N-Pulse/Haptics-2026/Mechanics/CAD's/Flexion feedback/V1_Rotation_big_cylinder/Flexion_V1_main.stl

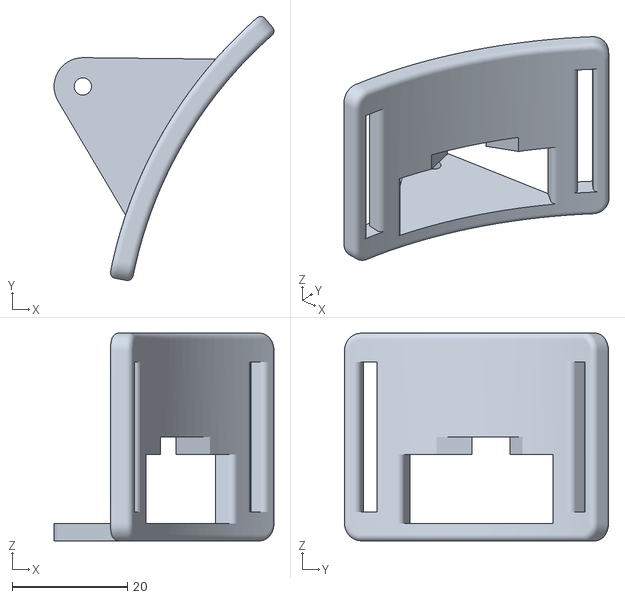
[picture p16: CAD file, 2026-10-17]
Mechanics/CAD's/Flexion feedback/V1_Rotation_big_cylinder/Flexion_V1_main.stl
38.1 x 45.8 x 36.0
