N-Pulse/Haptics-2026/Mechanics/CAD's/Flexion feedback/V2_Rotation_2_small_cylinders/Flexion_V2_main.stl

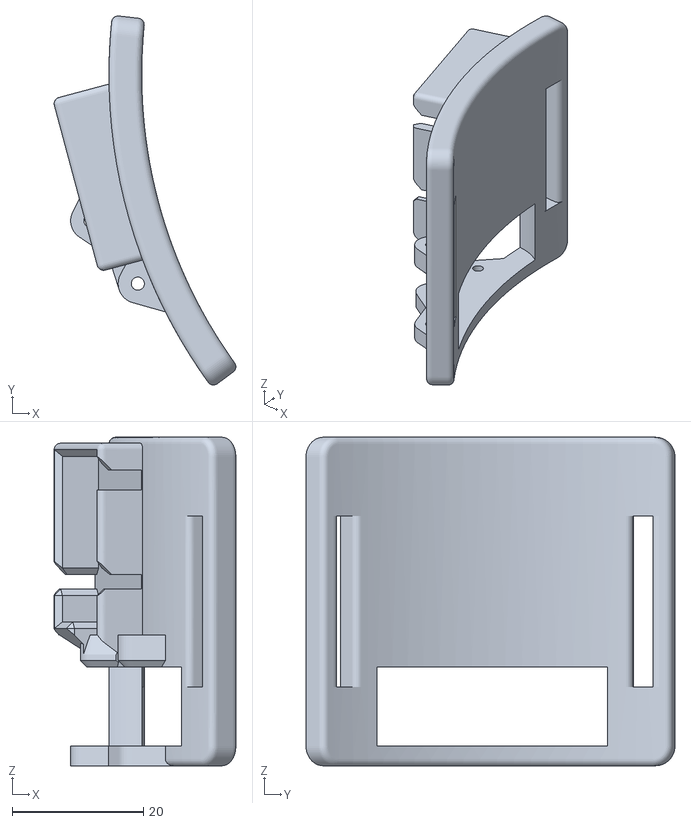
[picture p17: CAD file, 2026-10-17]
Mechanics/CAD's/Flexion feedback/V2_Rotation_2_small_cylinders/Flexion_V2_main.stl
27.7 x 56.2 x 50.0
