N-Pulse/Haptics-2026/Mechanics/CAD's/Flexion feedback/V3_linear/Flexion_V3.3_main.stl

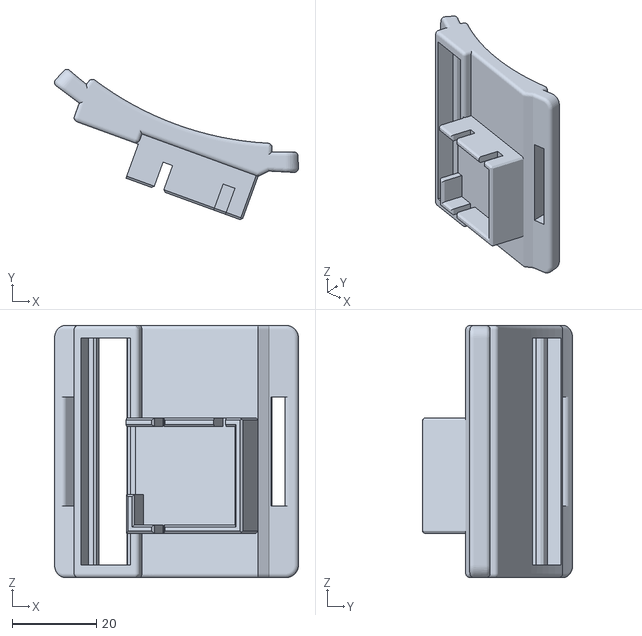
[picture p18: CAD file, 2026-10-30]
Mechanics/CAD's/Flexion feedback/V3_linear/Flexion_V3.3_main.stl
58.0 x 35.8 x 60.0
