N-Pulse/Haptics-2026/Mechanics/CAD's/Battery pack/Battery_board_V1_main.stl

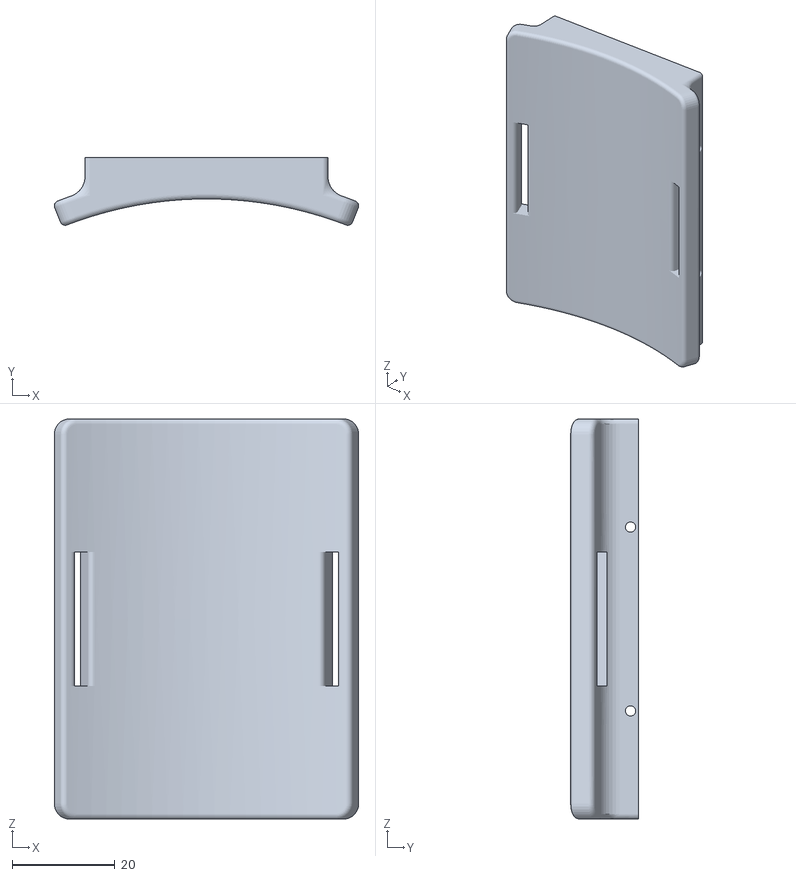
[picture p19: CAD file, 2026-10-23]
Mechanics/CAD's/Battery pack/Battery_board_V1_main.stl
59.1 x 13.1 x 77.7
