N-Pulse/Haptics-2026/Mechanics/CAD's/Pressure feedback/V3/Pressure_V3.1_main.stl

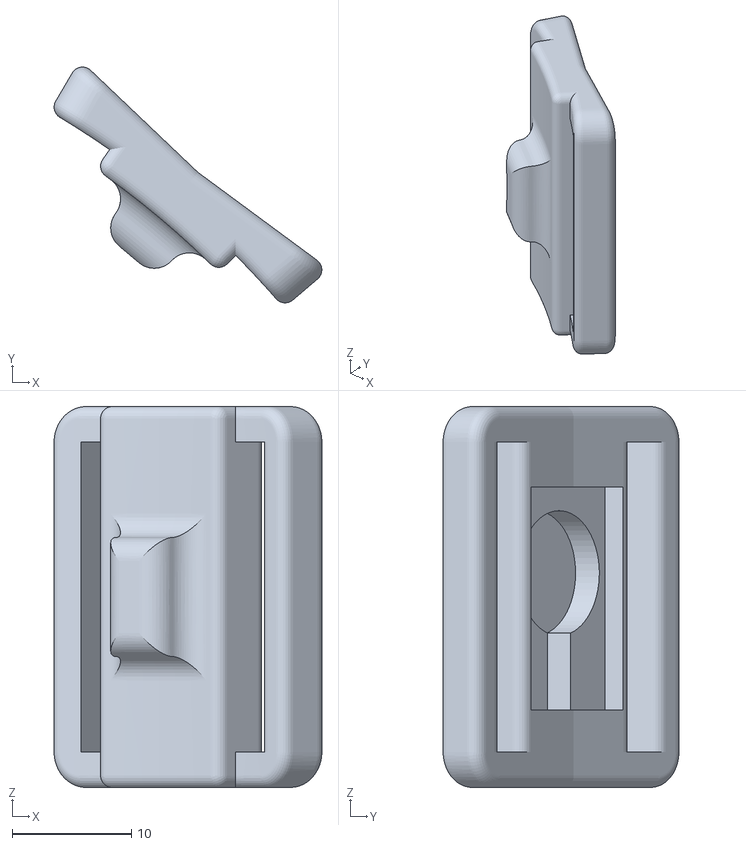
[picture p20: CAD file, 2026-10-30]
Mechanics/CAD's/Pressure feedback/V3/Pressure_V3.1_main.stl
22.5 x 19.8 x 32.0
