N-Pulse/Haptics-2026/Mechanics/CAD's/Battery pack/Battery_board_V1_second_stage.stl

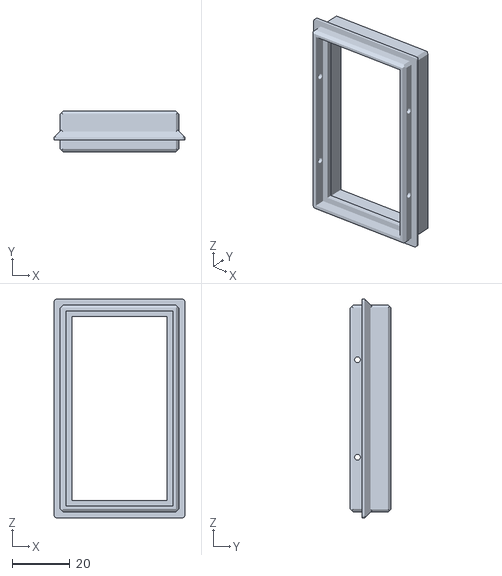
[picture p21: CAD file, 2026-10-23]
Mechanics/CAD's/Battery pack/Battery_board_V1_second_stage.stl
45.2 x 14.0 x 75.7
