N-Pulse/Haptics-2026/Mechanics/CAD's/Flexion feedback/V2_Rotation_2_small_cylinders/Flexion_V2_cylinders.stl

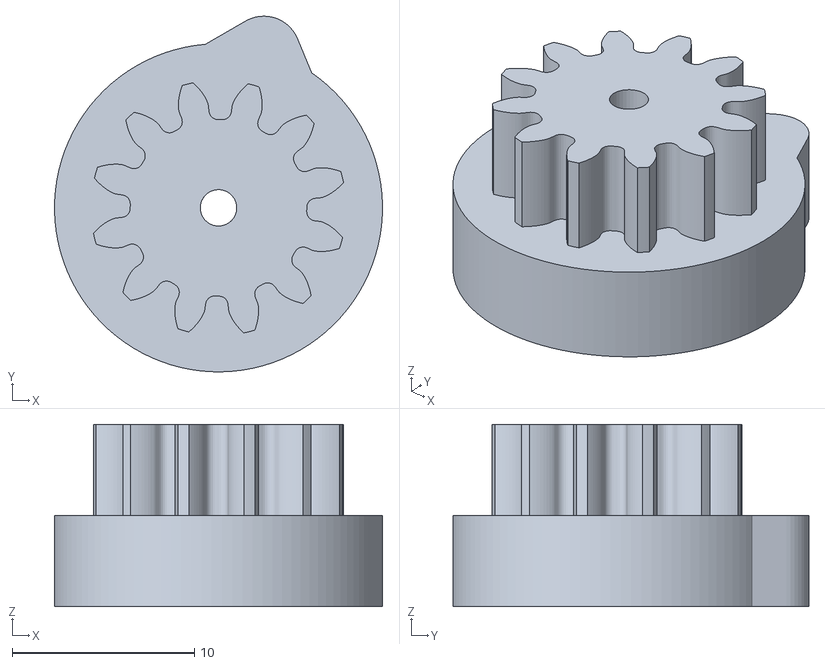
[picture p22: CAD file, 2026-10-17]
Mechanics/CAD's/Flexion feedback/V2_Rotation_2_small_cylinders/Flexion_V2_cylinders.stl
18.0 x 19.5 x 10.0
