N-Pulse/Haptics-2026/Mechanics/CAD's/Pressure feedback/V3/Pressure_V3.1_cap.stl

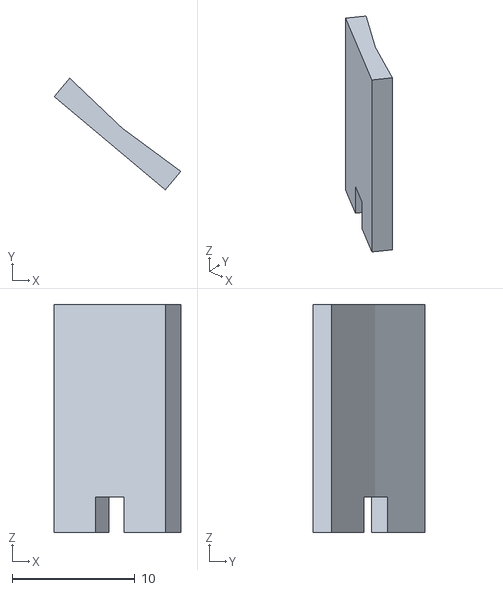
[picture p23: CAD file, 2026-10-30]
Mechanics/CAD's/Pressure feedback/V3/Pressure_V3.1_cap.stl
10.3 x 9.09 x 18.5
