N-Pulse/Haptics-2026/Mechanics/CAD's/Battery pack/Battery_board_V1_first_stage.stl

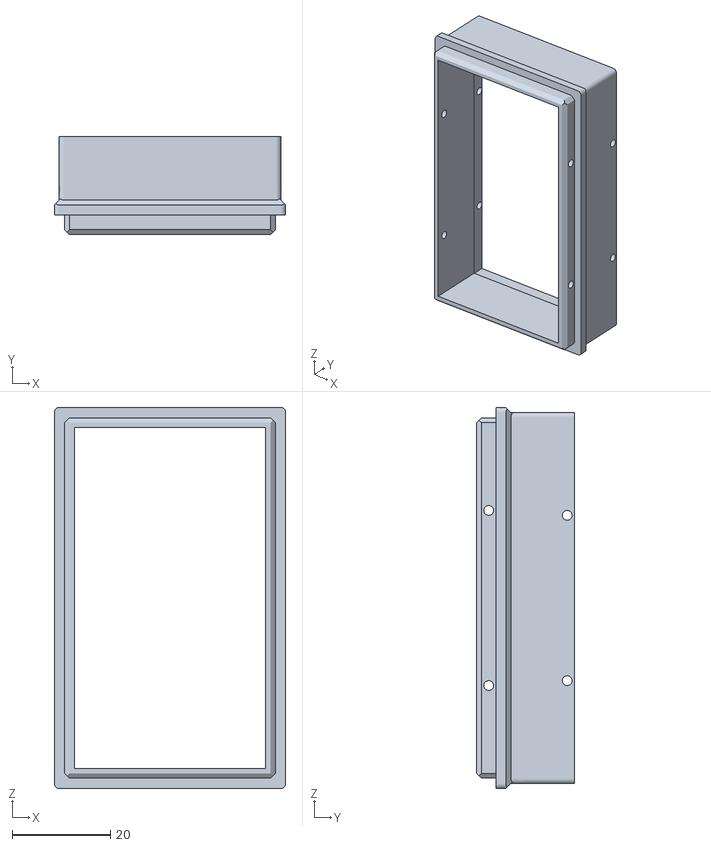
[picture p24: CAD file, 2026-10-23]
Mechanics/CAD's/Battery pack/Battery_board_V1_first_stage.stl
47.2 x 20.0 x 77.7
