N-Pulse/Haptics-2026/Mechanics/CAD's/Flexion feedback/V1_Rotation_big_cylinder/Flexion_V1.2_stand.stl

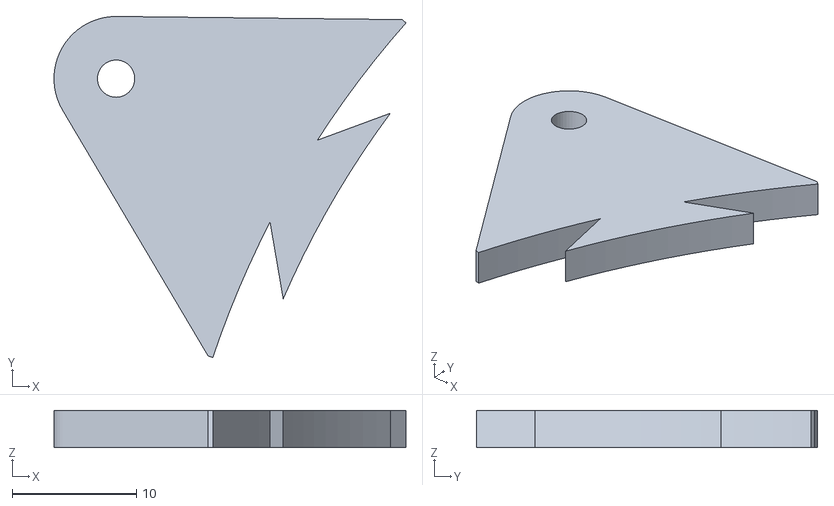
[picture p25: CAD file, 2026-10-17]
Mechanics/CAD's/Flexion feedback/V1_Rotation_big_cylinder/Flexion_V1.2_stand.stl
28.3 x 27.4 x 3.00
