N-Pulse/Haptics-2026/Mechanics/CAD's/Flexion feedback/V2_Rotation_2_small_cylinders/Flexion_V2_gear.stl

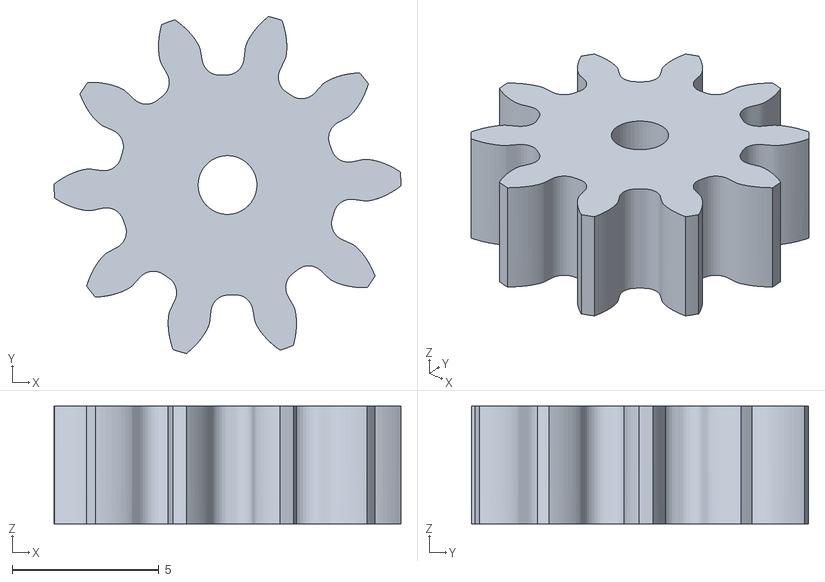
[picture p26: CAD file, 2026-10-17]
Mechanics/CAD's/Flexion feedback/V2_Rotation_2_small_cylinders/Flexion_V2_gear.stl
11.8 x 11.5 x 4.00
