N-Pulse/Haptics-2026/Mechanics/CAD's/Pressure feedback/V3/Pressure_V3_vibration_case.stl

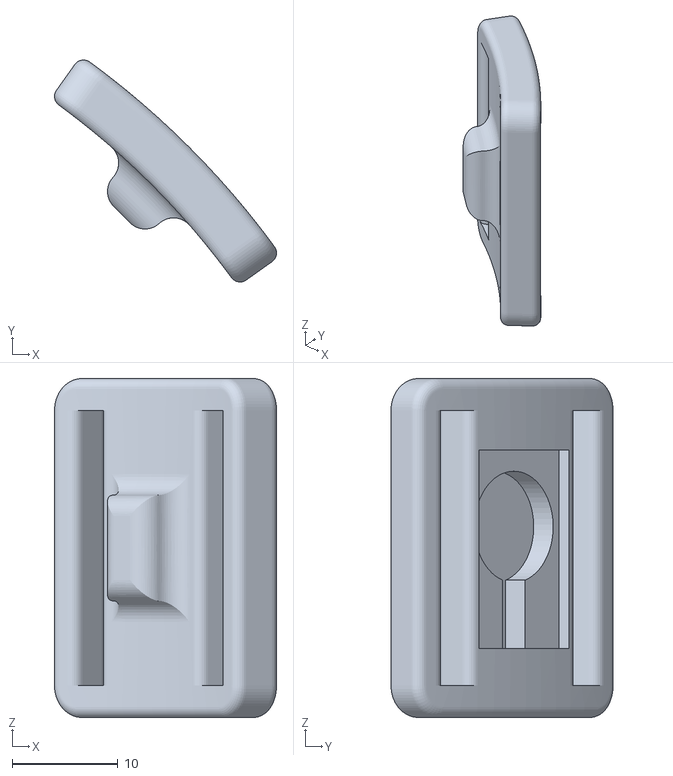
[picture p27: CAD file, 2026-10-30]
Mechanics/CAD's/Pressure feedback/V3/Pressure_V3_vibration_case.stl
21.0 x 21.0 x 32.0
