N-Pulse/Haptics-2026/Mechanics/CAD's/Battery pack/Battery_board_V1_cap.stl

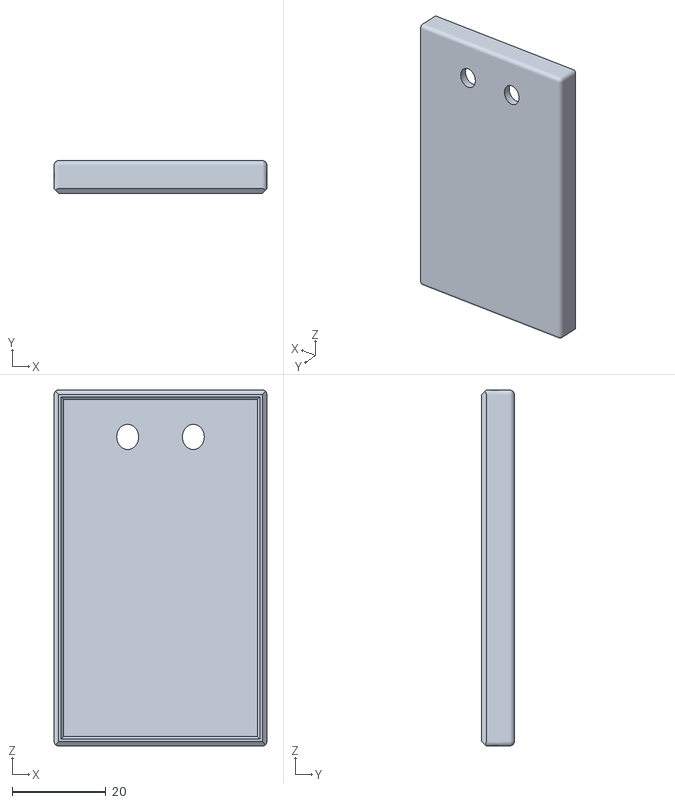
[picture p28: CAD file, 2026-10-23]
Mechanics/CAD's/Battery pack/Battery_board_V1_cap.stl
45.4 x 7.00 x 75.9
