N-Pulse/Haptics-2026/Mechanics/CAD's/Flexion feedback/V1_Rotation_big_cylinder/Flexion_V1_big_cylinder.stl

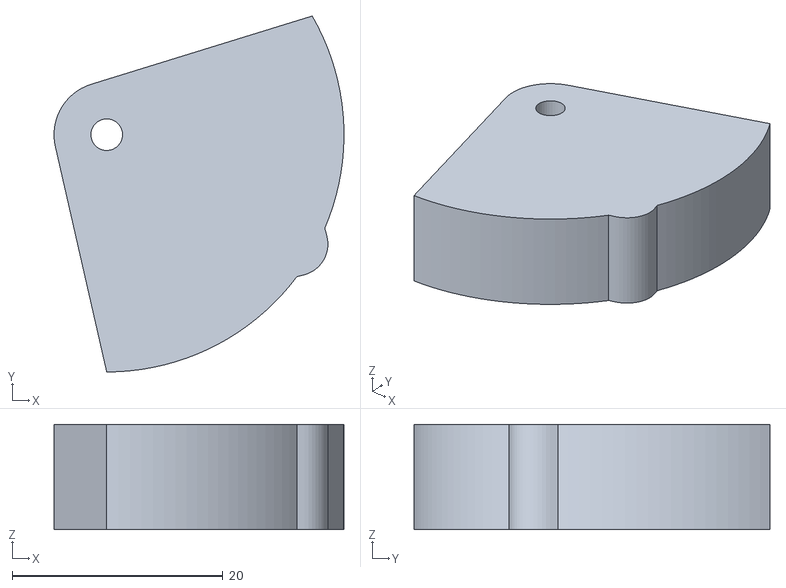
[picture p29: CAD file, 2026-10-17]
Mechanics/CAD's/Flexion feedback/V1_Rotation_big_cylinder/Flexion_V1_big_cylinder.stl
27.5 x 33.8 x 10.0
