N-Pulse/Haptics-2026/Mechanics/CAD's/Flexion feedback/V2_Rotation_2_small_cylinders/Flexion_V2_servo_cap.stl

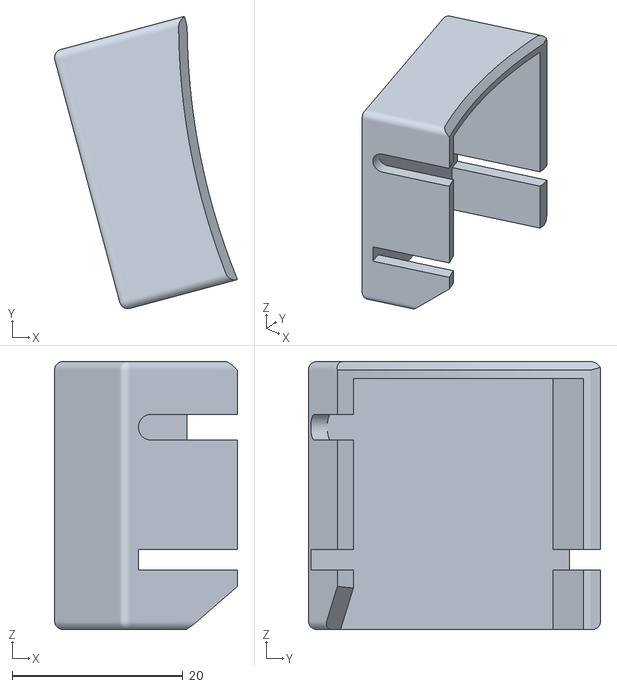
[picture p30: CAD file, 2026-10-17]
Mechanics/CAD's/Flexion feedback/V2_Rotation_2_small_cylinders/Flexion_V2_servo_cap.stl
21.4 x 34.2 x 31.4
