N-Pulse/Haptics-2026/Mechanics/CAD's/Flexion feedback/V3_linear/Flexion_V3.1_gear.stl

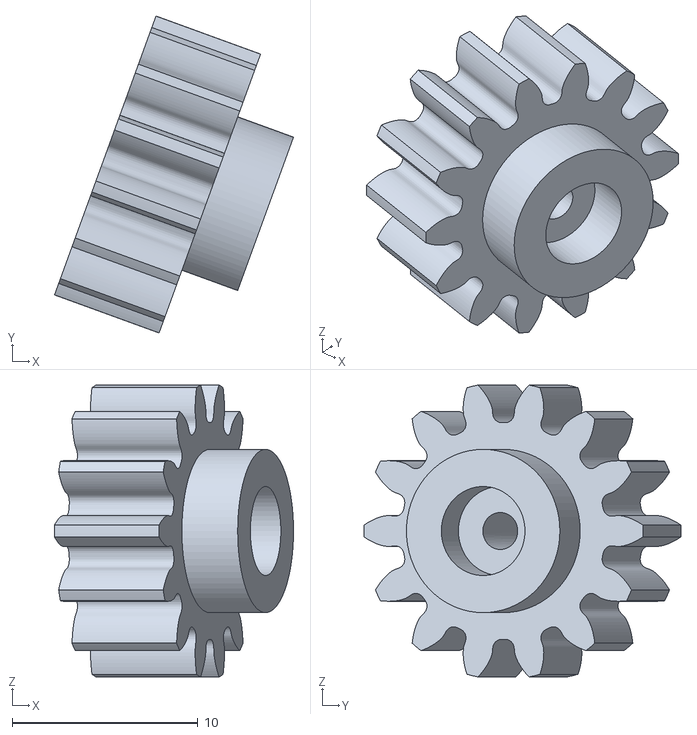
[picture p31: CAD file, 2026-10-30]
Mechanics/CAD's/Flexion feedback/V3_linear/Flexion_V3.1_gear.stl
12.9 x 17.1 x 15.7
