N-Pulse/Haptics-2026/Mechanics/CAD's/Flexion feedback/V3_linear/Flexion_V3.4_top_rail_part.stl

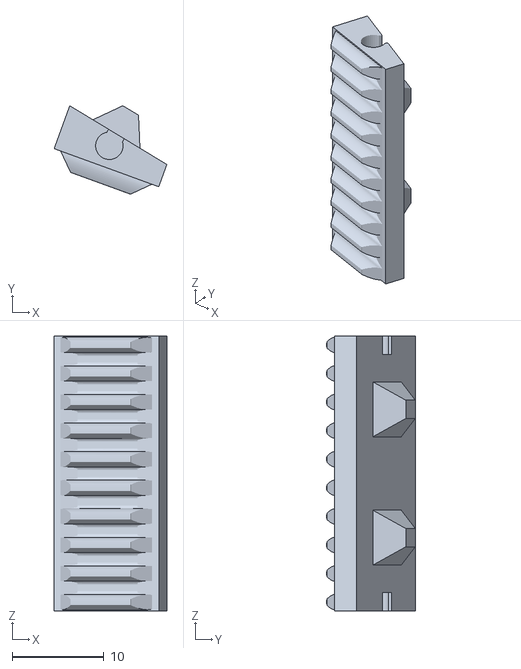
[picture p32: CAD file, 2026-10-30]
Mechanics/CAD's/Flexion feedback/V3_linear/Flexion_V3.4_top_rail_part.stl
12.3 x 9.66 x 30.0
