N-Pulse/Haptics-2026/Mechanics/CAD's/Flexion feedback/V3_linear/Flexion_V3.3_cap.stl

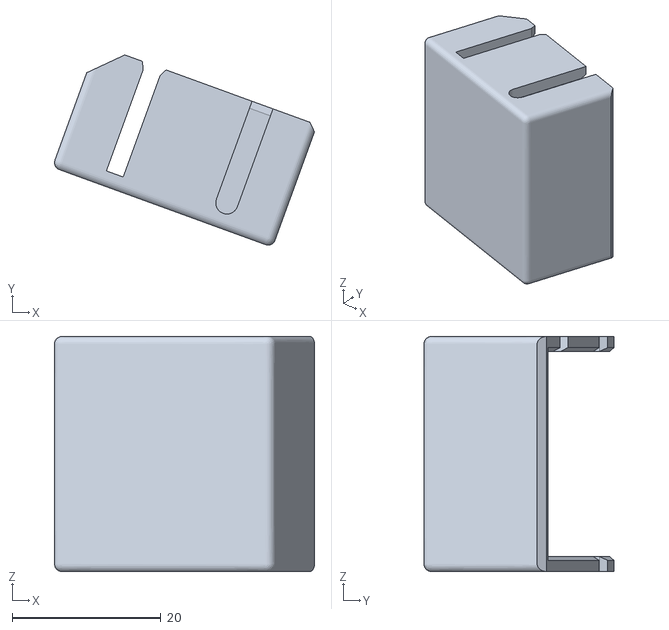
[picture p33: CAD file, 2026-10-30]
Mechanics/CAD's/Flexion feedback/V3_linear/Flexion_V3.3_cap.stl
35.0 x 25.6 x 31.6
