N-Pulse/Haptics-2026/Mechanics/CAD's/Flexion feedback/V3_linear/Flexion_V3.2_pin.stl

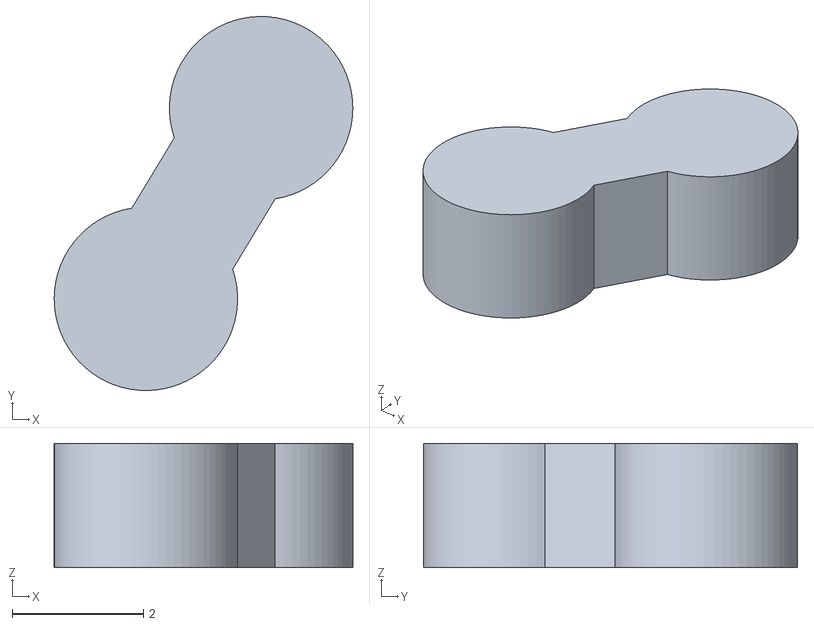
[picture p34: CAD file, 2026-10-23]
Mechanics/CAD's/Flexion feedback/V3_linear/Flexion_V3.2_pin.stl
4.56 x 5.71 x 1.90
