N-Pulse/Haptics-2026/Mechanics/CAD's/Flexion feedback/V3_linear/Flexion_V3.2_bottom_rail_part.stl

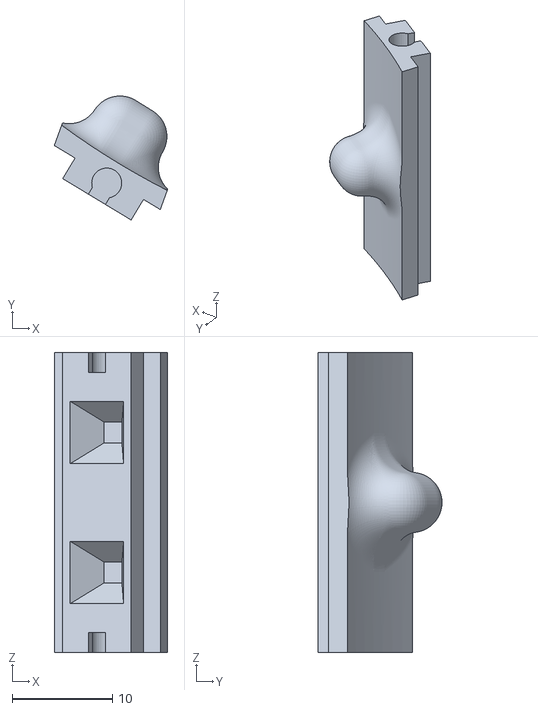
[picture p35: CAD file, 2026-10-23]
Mechanics/CAD's/Flexion feedback/V3_linear/Flexion_V3.2_bottom_rail_part.stl
11.3 x 12.4 x 30.0
