N-Pulse/Haptics-2026/Mechanics/CAD's/Flexion feedback/V3_linear/Flexion_V3.1_adaptor_gear.stl

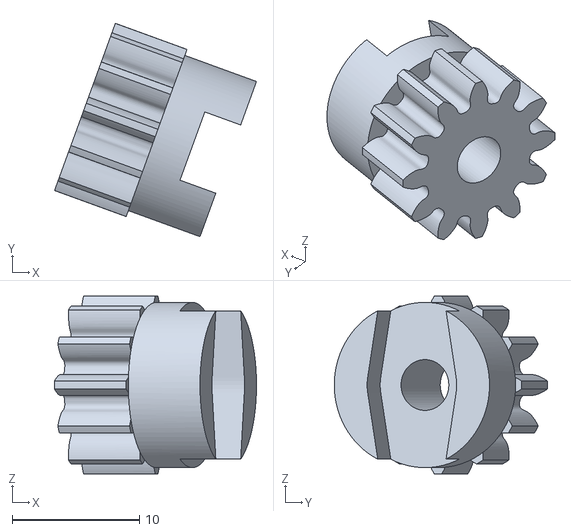
[picture p36: CAD file, 2026-10-21]
Mechanics/CAD's/Flexion feedback/V3_linear/Flexion_V3.1_adaptor_gear.stl
15.9 x 16.8 x 14.0
