N-Pulse/Haptics-2026/Mechanics/CAD's/Flexion feedback/V3_linear/Flexion_V3.1_adapted_gear.stl

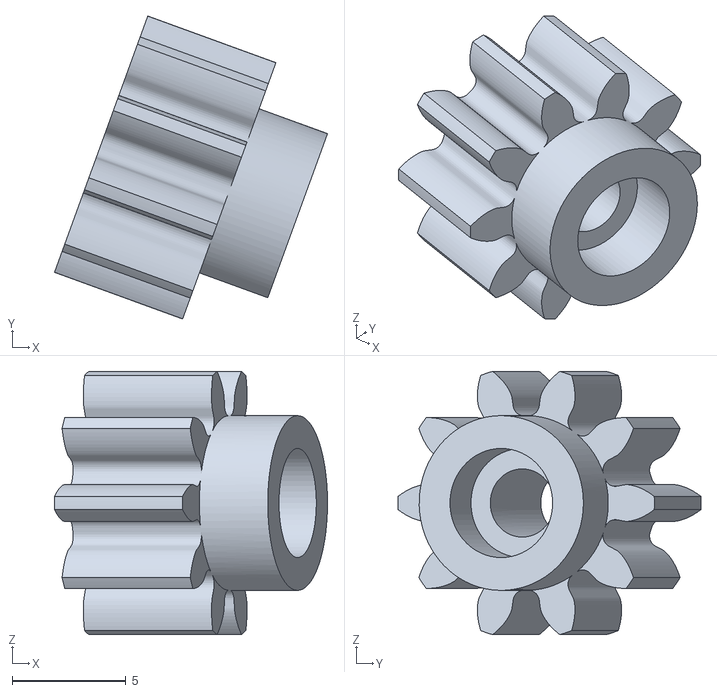
[picture p37: CAD file, 2026-10-21]
Mechanics/CAD's/Flexion feedback/V3_linear/Flexion_V3.1_adapted_gear.stl
12.0 x 13.3 x 11.6
