N-Pulse/Haptics-2026/Mechanics/CAD's/Flexion feedback/V3_linear/Flexion_V3_servo_cap.stl

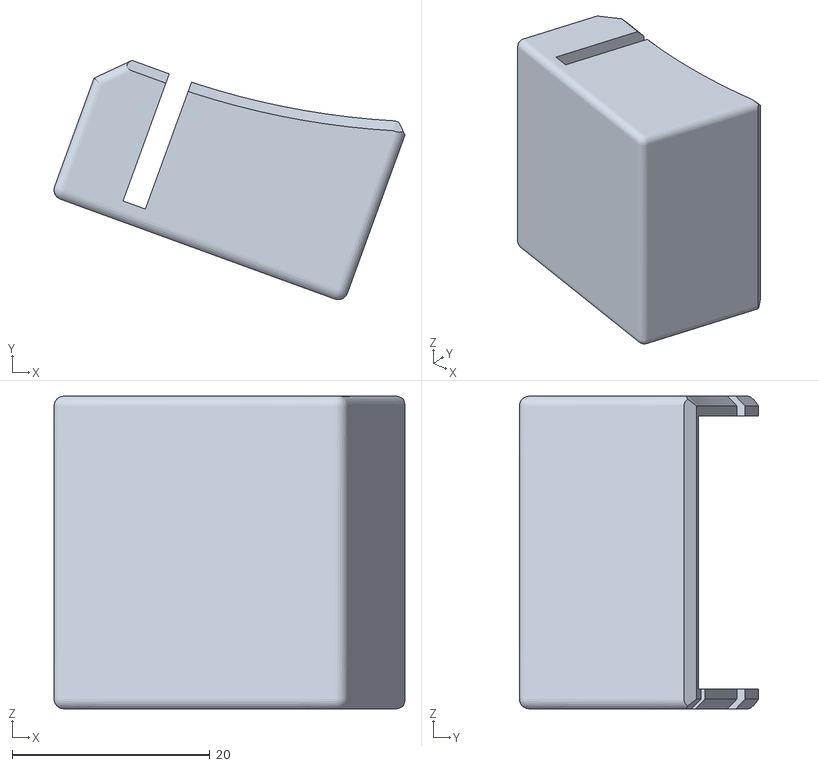
[picture p38: CAD file, 2026-10-17]
Mechanics/CAD's/Flexion feedback/V3_linear/Flexion_V3_servo_cap.stl
35.5 x 24.2 x 31.6
