N-Pulse/Haptics-2026/(list of files, cad)

Other CAD files:
Mechanics/CAD's/Flexion feedback/V1_Rotation_big_cylinder/Flexion_V1.0_stand.stl
Mechanics/CAD's/Flexion feedback/V3_linear/Flexion_V3.1_bottom_rail_part.stl
Mechanics/CAD's/Flexion feedback/V3_linear/Flexion_V3.1_cap.stl
Mechanics/CAD's/Flexion feedback/V3_linear/Flexion_V3.1_main.stl
Mechanics/CAD's/Flexion feedback/V3_linear/Flexion_V3.1_pin.stl
Mechanics/CAD's/Flexion feedback/V3_linear/Flexion_V3.1_top_rail_part.stl
Mechanics/CAD's/Flexion feedback/V3_linear/Flexion_V3.2_cap.stl
Mechanics/CAD's/Flexion feedback/V3_linear/Flexion_V3.2_main.stl
Mechanics/CAD's/Flexion feedback/V3_linear/Flexion_V3.2_top_rail_part.stl
Mechanics/CAD's/Flexion feedback/V3_linear/Flexion_V3.3_top_rail_part.stl
Mechanics/CAD's/Flexion feedback/V3_linear/Flexion_V3_adapted_gear.stl
Mechanics/CAD's/Flexion feedback/V3_linear/Flexion_V3_adaptor_gear.stl
Mechanics/CAD's/Flexion feedback/V3_linear/Flexion_V3_bottom_rail_part.stl
Mechanics/CAD's/Flexion feedback/V3_linear/Flexion_V3_gear.stl
Mechanics/CAD's/Flexion feedback/V3_linear/Flexion_V3_main.stl
Mechanics/CAD's/Flexion feedback/V3_linear/Flexion_V3_pin.stl
Mechanics/CAD's/Flexion feedback/V3_linear/Flexion_V3_top_rail_part.stl
Mechanics/CAD's/Pressure feedback/V1/Vibration 1.stl
Mechanics/CAD's/Pressure feedback/V2/Vibration cap.stl
Mechanics/CAD's/Pressure feedback/V2/Vibration case.stl
Mechanics/CAD's/Pressure feedback/V3/Pressure_V3_cap.stl
