N-Pulse/Haptics-2026/Firmware/Tests/silicon_tests/results.txt

Bare sensors on Ana's finger, force measured with scale, finger parallel to plane

--- RESULTS ---
Level: L
Voltage mean (V): 0.075
Voltage min (V): 0.000
Voltage max (V): 0.103
Voltage range (V): 0.103
Voltage SD (V): 0.028
Resistance mean (ohm): 76691.8
Resistance min (ohm): 47714.3
Resistance max (ohm): 1022000.0
Resistance range (ohm): 974285.7
Resistance SD (ohm): 76125.9

--- RESULTS ---
Level: M
Voltage mean (V): 0.299
Voltage min (V): 0.230
Voltage max (V): 0.362
Voltage range (V): 0.132
Voltage SD (V): 0.024
Resistance mean (ohm): 15824.8
Resistance min (ohm): 12824.3
Resistance max (ohm): 20766.0
Resistance range (ohm): 7941.6
Resistance SD (ohm): 1447.1

--- RESULTS ---
Level: H
Voltage mean (V): 0.901
Voltage min (V): 0.753
Voltage max (V): 1.041
Voltage range (V): 0.288
Voltage SD (V): 0.065
Resistance mean (ohm): 4577.8
Resistance min (ohm): 3802.8
Resistance max (ohm): 5642.9
Resistance range (ohm): 1840.0
Resistance SD (ohm): 416.2

Sensor + silicon coating v1 on Ana's finger, force measured with scale, finger parallel to plane

--- RESULTS ---
Level: L
Voltage mean (V): 0.004
Voltage min (V): 0.000
Voltage max (V): 0.088
Voltage range (V): 0.088
Voltage SD (V): 0.015
Resistance mean (ohm): 105026.9
Resistance min (ohm): 55833.3
Resistance max (ohm): 340000.0
Resistance range (ohm): 284166.7
Resistance SD (ohm): 77708.8

--- RESULTS ---
Level: M
Voltage mean (V): 0.190
Voltage min (V): 0.147
Voltage max (V): 0.225
Voltage range (V): 0.078
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

--- RESULTS ---
Level: H
Voltage mean (V): 0.474
Voltage min (V): 0.327
Voltage max (V): 0.606
Voltage range (V): 0.279
Voltage SD (V): 0.080
Resistance mean (ohm): 9865.2
Resistance min (ohm): 7250.0
Resistance max (ohm): 14268.7
Resistance range (ohm): 7018.7
Resistance SD (ohm): 1893.7
