N-Pulse/Haptics-2026/Firmware/Tests/silicon_tests/graph_finaltests.xlsx

 | Force (kg) | Voltage (V)
Light | 0.2 | 0.242
Medium | 0.4 | 0.488
Strong | 1 | 1.199
