N-Pulse/Haptics-2026/Electronics/HapticsFinal/HapticsFinal.kicad_pcb

## KiCad design Electronics/HapticsFinal/HapticsFinal.kicad_pcb (2026-10-11)

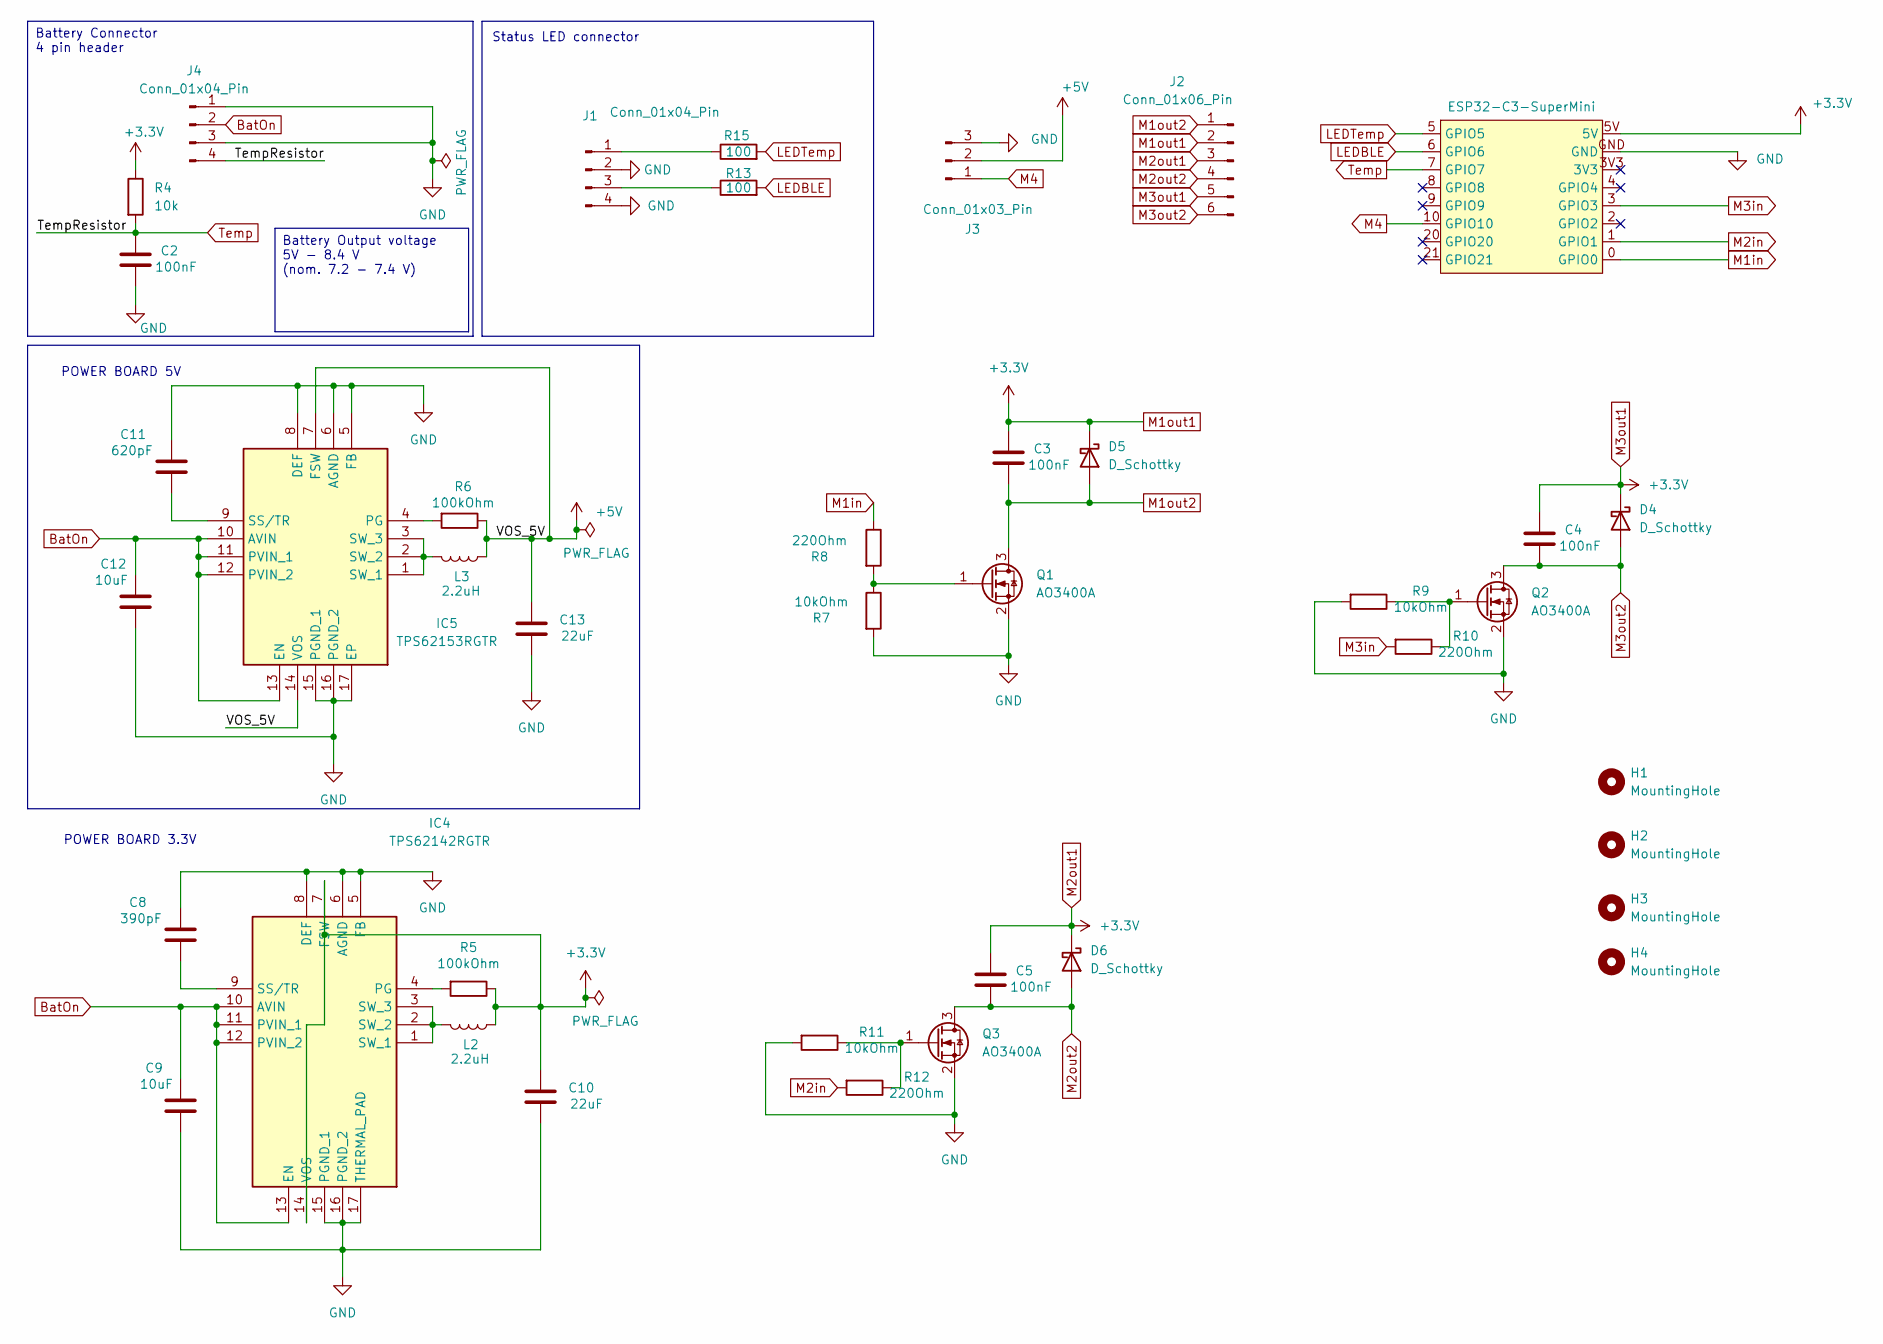
[picture p39: schematic HapticsFinal.kicad_sch]

Parts:
C2, C3, C4, C5: 100nF; C_1206_3216Metric_Pad1.33x1.80mm_HandSolder
C8: 390pF; C_0603_1608Metric_Pad1.08x0.95mm_HandSolder
C9, C12: 10uF; C_0603_1608Metric_Pad1.08x0.95mm_HandSolder
C10, C13: 22uF; C_1210_3225Metric_Pad1.33x2.70mm_HandSolder
C11: 620pF; C_0603_1608Metric_Pad1.08x0.95mm_HandSolder
D4, D5, D6: D_Schottky; D_SOD-123F
H1, H2, H3, H4: MountingHole; MountingHole_2.2mm_M2
IC4: TPS62142RGTR; QFN50P300X300X100-17N-D; Manufacturer_Part_Number TPS62142RGTR; Mouser Part Number 595-TPS62142RGTR
IC5: TPS62153RGTR; QFN50P300X300X100-17N-D; Manufacturer_Part_Number TPS62153RGTR; Mouser Part Number 595-TPS62153RGTR
J1, J4: Conn_01x04_Pin; PinHeader_1x04_P1.00mm_Vertical
J2: Conn_01x06_Pin; PinHeader_1x06_P1.00mm_Vertical
J3: Conn_01x03_Pin; PinHeader_1x03_P1.00mm_Vertical
L2, L3: 2.2uH; 1269ASH100NP2
Q1, Q2, Q3: AO3400A; SOT-23
R4: 10k; R_0603_1608Metric_Pad0.98x0.95mm_HandSolder
R5, R6: 100kOhm; R_0603_1608Metric_Pad0.98x0.95mm_HandSolder
R7, R9, R11: 10kOhm; R_0603_1608Metric_Pad0.98x0.95mm_HandSolder
R8, R10, R12: 220Ohm; R_0603_1608Metric_Pad0.98x0.95mm_HandSolder
R13, R15: 100; R_0603_1608Metric_Pad0.98x0.95mm_HandSolder
U2: ESP32-C3-SuperMini

Connections:
+5V: C13.2, IC5.7 (FSW), IC5.14 (VOS), J3.2, L3.1, R6.1
BatOn: C9.1, C12.1, IC4.10 (AVIN), IC4.11 (PVIN_1), IC4.12 (PVIN_2), IC4.13 (EN), IC5.10 (AVIN), IC5.11 (PVIN_1), IC5.12 (PVIN_2), IC5.13 (EN), J4.2
GND: C2.2, C8.1, C9.2, C10.1, C11.1, C12.2, C13.1, IC4.5 (FB), IC4.6 (AGND), IC4.8 (DEF), IC4.15 (PGND_1), IC4.16 (PGND_2), IC4.17 (THERMAL_PAD), IC5.5 (FB), IC5.6 (AGND), IC5.8 (DEF), IC5.15 (PGND_1), IC5.16 (PGND_2), IC5.17 (EP), J1.2, J1.4, J3.3, J4.1, J4.3, Q1.2 (S), Q2.2 (S), Q3.2 (S), R7.2, R9.2, R11.2, U2.GND
LEDBLE: R13.2, U2.6 (GPIO6)
LEDTemp: R15.2, U2.5 (GPIO5)
M1in: R8.1, U2.0 (GPIO0)
M1out1: C3.1, C4.1, C5.1, C10.2, D4.1 (K), D5.1 (K), D6.1 (K), IC4.7 (FSW), IC4.14 (VOS), J2.2, J2.3, J2.5, L2.1, R4.1, R5.1, U2.5V
M1out2: C3.2, D5.2 (A), J2.1, Q1.3 (D)
M2in: R12.2, U2.1 (GPIO1)
M2out2: C5.2, D6.2 (A), J2.4, Q3.3 (D)
M3in: R10.2, U2.3 (GPIO3)
M3out2: C4.2, D4.2 (A), J2.6, Q2.3 (D)
M4: J3.1, U2.10 (GPIO10)
unnamed: IC4.4 (PG), R5.2
unnamed: C8.2, IC4.9 (SS/TR)
unnamed: IC4.1 (SW_1), IC4.2 (SW_2), IC4.3 (SW_3), L2.2
unnamed: IC5.4 (PG), R6.2
unnamed: C11.2, IC5.9 (SS/TR)
unnamed: IC5.1 (SW_1), IC5.2 (SW_2), IC5.3 (SW_3), L3.2
unnamed: J1.1, R15.1
unnamed: J1.3, R13.1
unnamed: Q1.1 (G), R7.1, R8.2
unnamed: Q2.1 (G), R9.1, R10.1
unnamed: Q3.1 (G), R11.1, R12.1
Temp: C2.1, J4.4, R4.2, U2.7 (GPIO7)

Notes on the sheet:
Status LED connector
POWER BOARD 3.3V
POWER BOARD 5V
Battery Connector 4 pin header
Battery Output voltage 5V - 8.4 V (nom. 7.2 - 7.4 V)

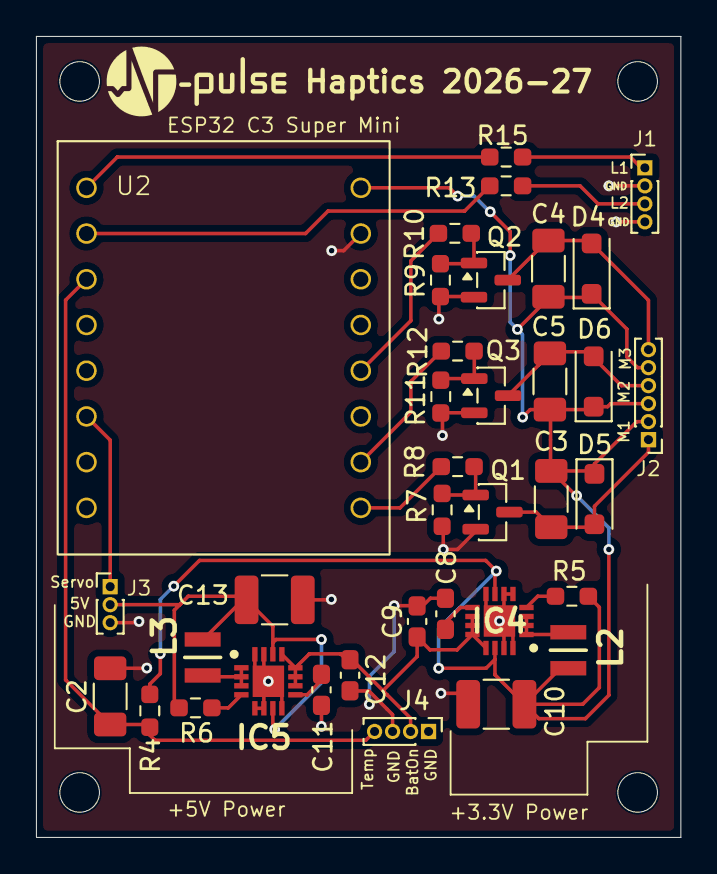
[picture p40: board HapticsFinal.kicad_pcb from above]

Board: 2 copper layers, 35.8 x 44.5 mm, 40 parts (0 on the bottom side), 25 nets.
