N-Pulse/Haptics-2026/(commit log)

2026-10-09 Add PCB and Gerber files
    [HapticsFinal.kicad_pcb, HapticsFinal.kicad_sch]
2026-10-11 reviewed board : Changed Silkscreen for readability and cleared ERC & DRC errors
    [HapticsFinal-B_Cu.gbl, HapticsFinal-B_Mask.gbs, HapticsFinal-B_Paste.gbp, HapticsFinal-B_Silkscreen.gbo, HapticsFinal-Edge_Cuts.gm1, HapticsFinal-F_Cu.gtl, HapticsFinal-F_Mask.gts, HapticsFinal-F_Paste.gtp]
2026-10-13 organize folders
    [HapticsFinal-B_Cu.gbl, HapticsFinal-B_Mask.gbs, HapticsFinal-B_Paste.gbp, HapticsFinal-B_Silkscreen.gbo, HapticsFinal-Edge_Cuts.gm1, HapticsFinal-F_Cu.gtl, HapticsFinal-F_Mask.gts, HapticsFinal-F_Paste.gtp]
2026-10-17 adding cads and components sheets
    [Flexion_V1.0_stand.stl, Flexion_V1.2_stand.stl, Flexion_V1_big_cylinder.stl, Flexion_V1_main.stl, Flexion_V2_cylinders.stl, Flexion_V2_gear.stl, Flexion_V2_main.stl, Flexion_V2_servo_cap.stl]
2026-10-17 feat: add ESP32 BLE sender and receiver firmware
2026-10-20 fix: update ESP32 sender/receiver firmware, add temperature sensing
    [BLE_receiver.ino, BLE_sender.ino, controlingLED.ino, temperature.ino]
2026-10-21 change the gear and the rail for the flexion feedback
    [Flexion_V3.1_adapted_gear.stl, Flexion_V3.1_adaptor_gear.stl, Flexion_V3.1_bottom_rail_part.stl, Flexion_V3.1_pin.stl, Flexion_V3.1_top_rail_part.stl, Flexion_V3_adapted_gear.stl, Flexion_V3_adaptor_gear.stl]
2026-10-23 Added firmware section documentation with code and Bluetooth details
    Added detailed explanations of firmware architecture, Bluetooth communication, and the use of thresholds for noise filtering and safety. Included a code diagram and clarified the roles of sender and receiver sketches.
2026-10-23 SDR mech completed and battery/board CADs added
    [Battery_board_V1_cap.stl, Battery_board_V1_first_stage.stl, Battery_board_V1_main.stl, Battery_board_V1_second_stage.stl, Flexion_V3.1_cap.stl, Flexion_V3.1_main.stl, Flexion_V3.2_bottom_rail_part.stl, Flexion_V3.2_pin.stl]
2026-10-24 Update sender sketch to transmit servo position data
    Enhanced the sender sketch to include motor/servo position data transmission and added packet header structure for better data integrity.
2026-10-24 Added explanation for firmware
    Rearranged sections in the documentation to improve clarity and flow. Added details about two-way communication and safety protocols for BLE communication.
2026-10-24 Enhance PCB layout description and section title
    Expanded the description of Figure 1 to include details about the battery connection, power supply circuits, MCU, motor drivers, and LEDs interface. Updated section title to reflect temperature monitoring.
2026-10-29 add pressure sensor test
2026-10-30 modification of the flexion and pressure modules
    [Flexion_V3.1_gear.stl, Flexion_V3.2_cap.stl, Flexion_V3.2_main.stl, Flexion_V3.3_cap.stl, Flexion_V3.3_main.stl, Flexion_V3.3_top_rail_part.stl, Flexion_V3.4_top_rail_part.stl, Pressure_V3.1_cap.stl]
2026-11-03 Added demonstration code for STM32 with vibration motor and servo
    [servo_vib_stm32g431kb.ino]
